MissCrispenCakes/On-body-haptics/hardware/enclosures/raspberry-pi-case/README.md

# Raspberry Pi Case

3D printable enclosures for the Raspberry Pi haptic system.

## Design Credits

- **Initial designs**: MissCrispenCakes
- **Sample prints with battery compartment**: rglenn ([@rglenn](https://github.com/rglenn)) - Surprise contribution!

## License

Licensed under **CERN-OHL-P v2** (CERN Open Hardware License - Permissive)

See [LICENSE-HARDWARE](../../../LICENSE-HARDWARE) for full license text.

## Files

- **picase.scad** - OpenSCAD source file (parametric, editable)
- **picase.stl** - Ready-to-print 3D model

## Printing

### Recommended Settings

- **Material**: PLA or PETG
- **Layer Height**: 0.2mm
- **Infill**: 20%
- **Supports**: Yes (for overhangs)
- **Print Speed**: 50-60mm/s

### Battery Compartment

rglenn's sample prints include an integrated battery compartment for portable operation. This improvement allows the system to be truly wearable without external power cables.

## Modifications

You are free to modify these designs under CERN-OHL-P v2. The OpenSCAD source file (.scad) allows you to:
- Adjust dimensions
- Add custom mounting points
- Modify battery compartment size
- Create variants for different components

## Attribution

When sharing or manufacturing these designs, please include:

```
Raspberry Pi Case for On-Body Haptics
Initial design by MissCrispenCakes
Battery compartment samples by rglenn
https://github.com/MissCrispenCakes/On-body-haptics
Licensed under CERN-OHL-P v2
```

## Source Location

As required by CERN-OHL-P v2:

**Source Location**: https://github.com/MissCrispenCakes/On-body-haptics/tree/main/hardware/enclosures/raspberry-pi-case
