MissCrispenCakes/On-body-haptics/(list of files, cad)

Other CAD files:
hardware/enclosures/raspberry-pi-case/picase.stl
