MissCrispenCakes/On-body-haptics/(notices)

Notices in the files:
README.md:
Hardware License: CERN-OHL-P-2.0
